airqualitystation/hardware/README.md

# Air Quality Station :: Hardware
This repository contains details of equipment which we consider important to  highlight. In the **To_do** folder we list some improvements wich could be done for the next team. In this **README** note, you will find an overview of the schematic and the wiring of the air quality station.  

## Hardware requirements
* [STM32 Nucleo B-L072Z-LRWAN1](https://www.st.com/en/evaluation-tools/b-l072z-lrwan1.html)
* [SDS011](https://cdn-reichelt.de/documents/datenblatt/X200/SDS011-DATASHEET.pdf)
* [PMS7003](https://usermanual.wiki/Document/PMS7003seriesdata20manualEnglishV25.1220636559/view)
* [DHT22](https://cdn-shop.adafruit.com/datasheets/Digital+humidity+and+temperature+sensor+AM2302.pdf)
* [BME280](https://www.waveshare.com/w/upload/7/75/BME280_Environmental_Sensor_User_Manual_EN.pdf)
* [Solar Panel 180x80 mm](https://www.gotronic.fr/art-cellule-solaire-sol2w-18995.htm#complte_desc)
* [LiPo Battery 3.7 V / 2000 mAh](https://www.sparkfun.com/datasheets/Batteries/UnionBattery-2000mAh.pdf)
* [Solar Power Manager 5V](https://www.dfrobot.com/product-1712.html)
* [Analog digital converter ADS1115](https://www.adafruit.com/product/1085)

## Schematics

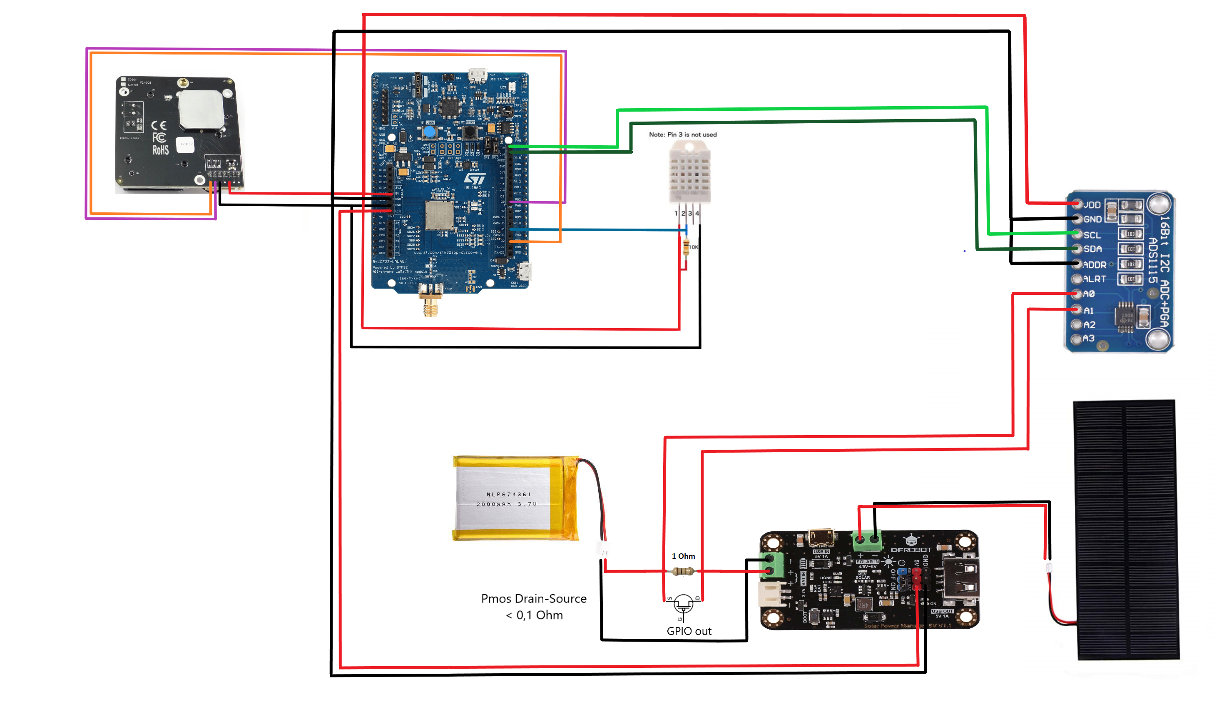
[picture p1: images/Schematic_2020.png]
Air Quality Station 2020

<p align="center">
  <i>Project schematic 2020 </i>
</p>

## Gallery
Air Quality Station 2020
<p align="center">
  <i>Weather station 2020 </i>
</p>
