airqualitystation/hardware/multimeter/Ltspice_simulation/ndp6020p_simulation.asc

Battery: voltage; 3.7
GPIO_output: voltage; 3.3
Load_to_fix_a_200_mA: res; 18.5
R1: res; 1
U1: ndp6020p
Named nets: 0
.tran 5s
